sschlein/weather-display/enclosure/stand.stl

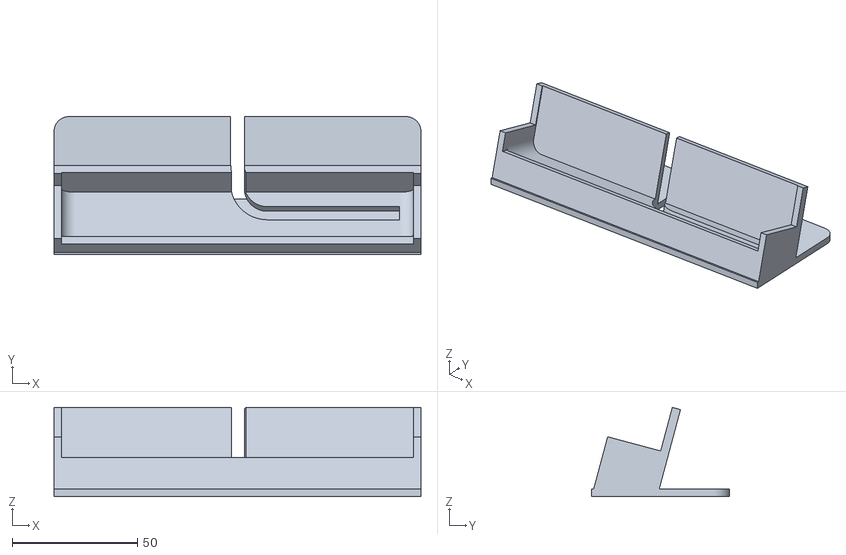
[picture p6: CAD file, 2026-11-04]
enclosure/stand.stl
146.5 x 55.0 x 35.6
