sschlein/weather-display/enclosure/sun.stl

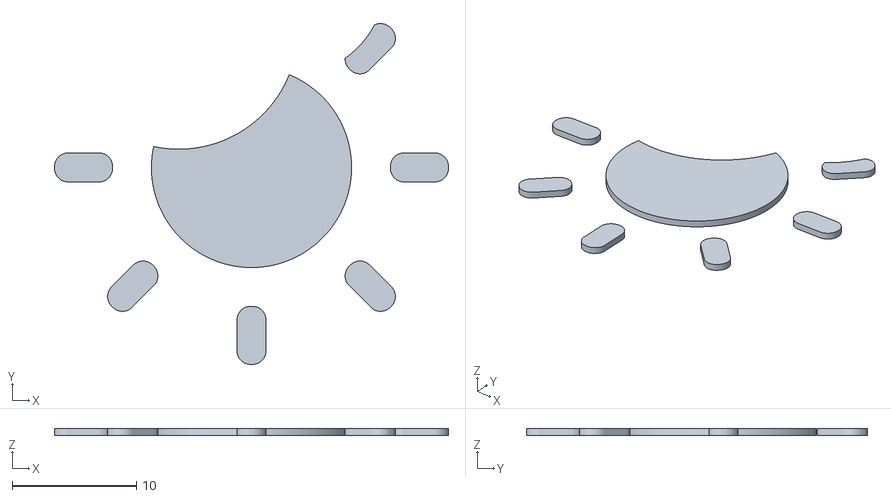
[picture p7: CAD file, 2026-11-03]
enclosure/sun.stl
31.7 x 27.4 x 0.6
