sschlein/weather-display/enclosure/fit-test.stl

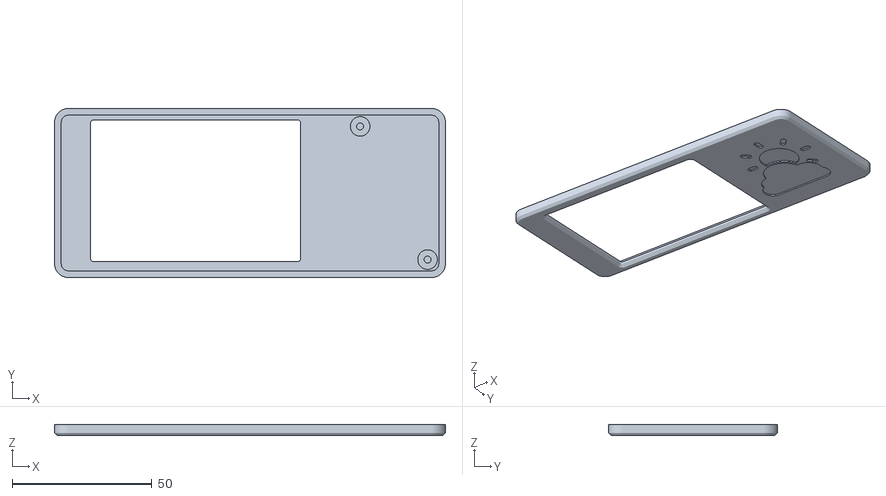
[picture p8: CAD file, 2026-11-03]
enclosure/fit-test.stl
139.7 x 60.4 x 4.00
