sschlein/weather-display/enclosure/back.stl

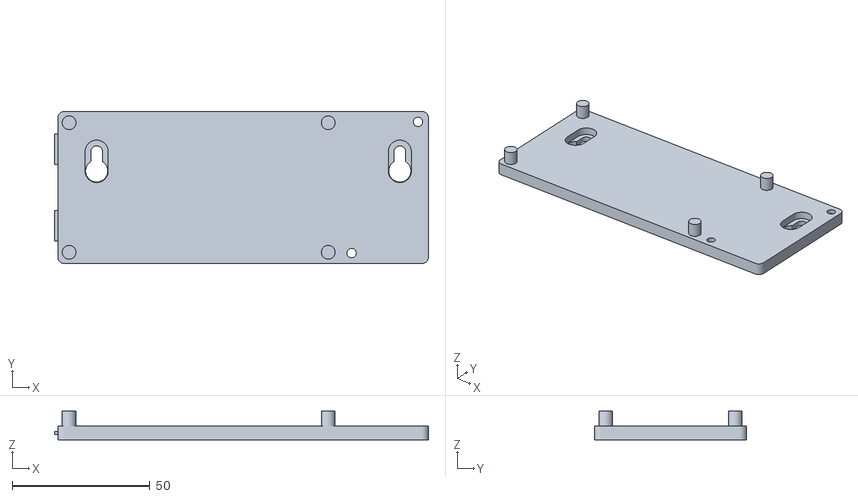
[picture p9: CAD file, 2026-11-03]
enclosure/back.stl
135.7 x 55.2 x 10.5
