sschlein/weather-display/enclosure/front.stl

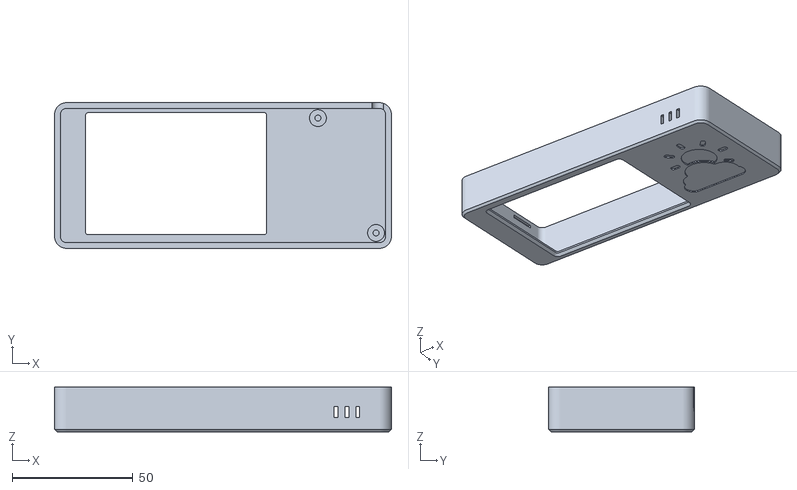
[picture p10: CAD file, 2026-11-03]
enclosure/front.stl
139.7 x 60.4 x 18.5
