sschlein/weather-display/enclosure/cloud.stl

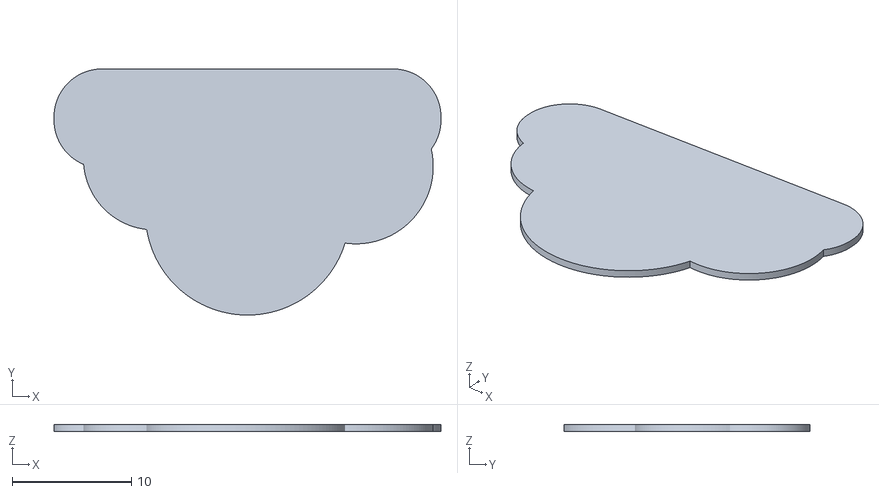
[picture p11: CAD file, 2026-11-03]
enclosure/cloud.stl
32.5 x 20.7 x 0.6
