sschlein/weather-display/(commit log)

2026-11-03 Weather display for the ESP32-3248S035C, with a printable case
    Temperature, rain radar ("Es beginnt in 25 Minuten zu regnen") and the
    next seven days on a 3.5" Cheap Yellow Display, from Bright Sky (DWD
    radar) and Open-Meteo. A wall case built in build123d, with a sun-and-cloud
    emblem inlaid in color.
    [back.stl, cloud.stl, fit-test.stl, front.stl, partitions.csv, sun.stl]
2026-11-03 Add a desk stand for the case
    The case stands in a cradle, leaning back 15°, held by a low lip in front,
    a rest behind and walls on both sides. The USB cable runs from the case's
    bottom right through a channel under it to the middle and out at the back.
    [stand.stl]
2026-11-04 Open the stand's cable channel from above, and slim the stand down
    A slot through the rest keeps the channel open all along, so the cable lies
    in from above and no plug has to fit through. Lip, rest, side walls and foot
    are 3 mm now, and the base under the case is just as tall as the channel
    needs.
    [stand.stl]
